hun186/cat-treat-feeder/docs/spoon-sourcing-and-reuse.md

# 常見 PP 圓匙：採購、尺寸與餐後留用

**這不是特殊的專用貓匙。** 類似的 PP 大圓匙可能就是一般餐廳供餐時附上的塑膠湯匙。相同的 155 mm 全長並不保證卡扣相容，必須核對柄寬、厚度與彎曲形狀。

## 已量測的範例匙（一般尺量，非正式公差）
- PP 大圓匙（不是大叉匙或叉匙）；總長約 **155 mm**，勺面寬約 **43 mm**、長約 **50 mm**。
- 柄最窄約 **9 mm**、最寬約 **14 mm**，厚約 **6 mm**，略有弧度。
- 距柄尾端：最寬處 **35 mm**、最窄處 **87 mm**、匙頭交界 **102 mm**。
- V1.14 前後卡扣距離 **52 mm**；前卡扣內寬 9.5 mm／入口 8.7 mm，後卡扣內寬 13.5 mm／入口 11.7 mm。

## 市售購買參考
賣場商品名稱：**大圓匙 大叉匙 100入/包 塑膠湯匙 免洗餐具 塑膠餐具 甜品湯匙 餐廚用品 圓匙 湯匙 走道G**。
請選 **「大圓匙」** 規格：[蝦皮商品頁](https://shopee.tw/%E5%A4%A7%E5%9C%93%E5%8C%99-%E5%A4%A7%E5%8F%89%E5%8C%99-100%E5%85%A5-%E5%8C%85-%E5%A1%91%E8%86%A0%E6%B9%AF%E5%8C%99-%E5%85%8D%E6%B4%97%E9%A4%90%E5%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)。

**包數不一致提醒：** 商品標題寫「100入／包」，先前的到貨包裝照片卻標示「50 PCS／包」；未證實兩者是否同款包裝。以當下賣場選項與實物為準。該連結僅是採購來源範例，非商業背書或食品認證。

## 餐後留用：降低浪費的一個方法
若餐廳提供了相同形狀、尺寸吻合的 PP 圓匙，用餐後可留下來：
1. 確認無裂痕、缺口、尖角或嚴重刮痕，不使用已變形的食匙。
2. 以洗碗精充分洗淨口水、食物與調味料，再用清水沖洗乾淨，晾乾並以潔淨容器收存。
3. 將它作為某隻貓的**個別乾淨食匙**，而不是直接給多隻貓輪流舔食。
4. 在跨地域、多貓或動物送養場域，**優先使用未用過的新匙並遵守場域 SOP**。清洗不等同已消毒，更不等於無菌。

## 風險應如何理解
- **主要避免的是貓與貓之間的間接傳播**。FCV 可經污染的食器等傳播；FPV 亦有環境與器具的間接傳播途徑。
- **人與貓的感染風險不是零**：特定貓病原（例如 FCV）不感染人，但仍有部分人畜共通病原。用餐後留下的湯匙須妥善清洗，不能把「人貓通常不同病」當作免清洗理由。
- 換匙只解決接觸端；若 3D 列印本體、手部或貓條袋沾到唾液，仍須清潔／適當消毒。
- 商用 PP 餐具需查商品的食品接觸標示，不能只看賣場文案認定符合規範。

參考：[Cornell FCV](https://www.vet.cornell.edu/departments-centers-and-institutes/baker-institute-animal-health/research-baker-institute/feline-calicivirus) · [Cornell FPV](https://www.vet.cornell.edu/departments-centers-and-institutes/cornell-feline-health-center/health-information/feline-health-topics/feline-panleukopenia-virus) · [CDC 清潔與消毒寵物用品](https://www.cdc.gov/healthy-pets/about/cleaning-and-disinfecting-pet-supplies.html) · [CDC Cats](https://www.cdc.gov/healthy-pets/about/cats.html)
