hun186/cat-treat-feeder/current/squeeze_slider_v1_14.stl

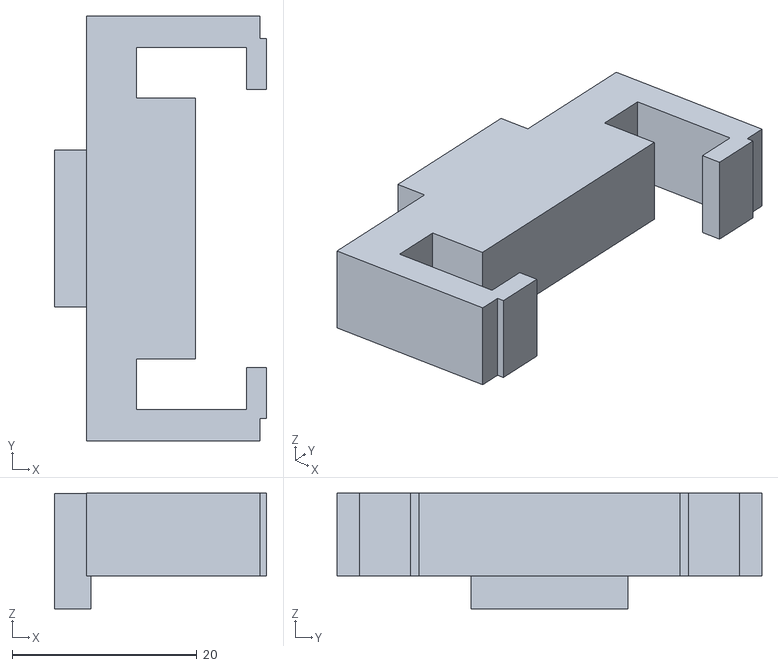
[picture p1: CAD file, 2026-11-04]
current/squeeze_slider_v1_14.stl
23.0 x 46.0 x 12.5
