hun186/cat-treat-feeder/history/v1.13/base_body_v1_13.stl

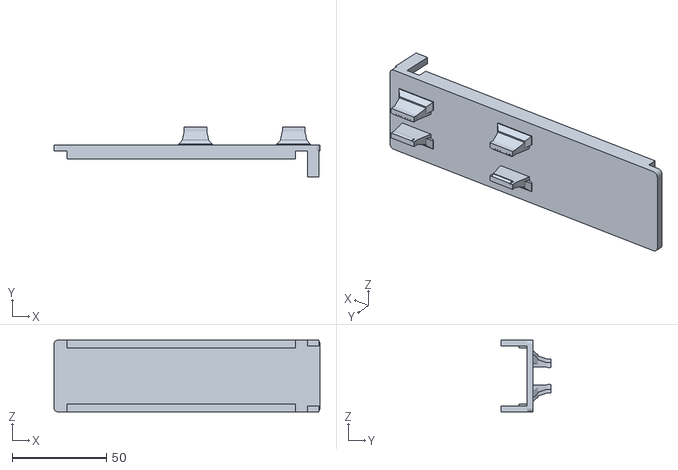
[picture p2: CAD file, 2026-11-04]
history/v1.13/base_body_v1_13.stl
141.0 x 26.5 x 38.0
