hun186/cat-treat-feeder/current/two_point_52mm_front_snap.stl

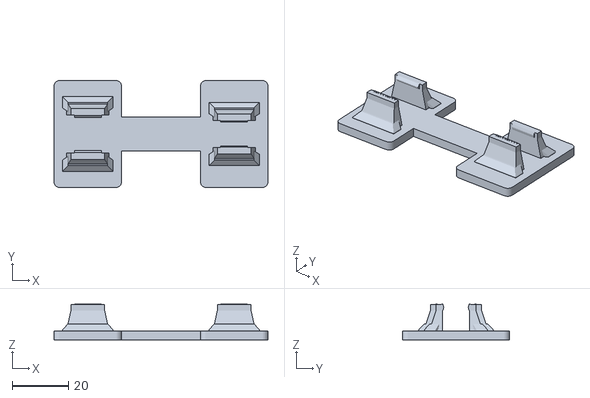
[picture p3: CAD file, 2026-11-04]
current/two_point_52mm_front_snap.stl
76.0 x 38.0 x 12.7
