hun186/cat-treat-feeder/current/front_snap_coupon_9p5_mouth8p7.stl

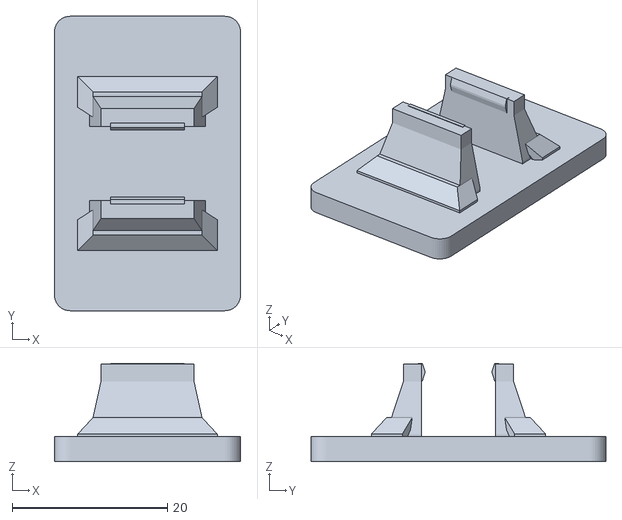
[picture p4: CAD file, 2026-11-04]
current/front_snap_coupon_9p5_mouth8p7.stl
24.0 x 38.0 x 12.7
