hun186/cat-treat-feeder/history/v1.11/base_body_v1_11.stl

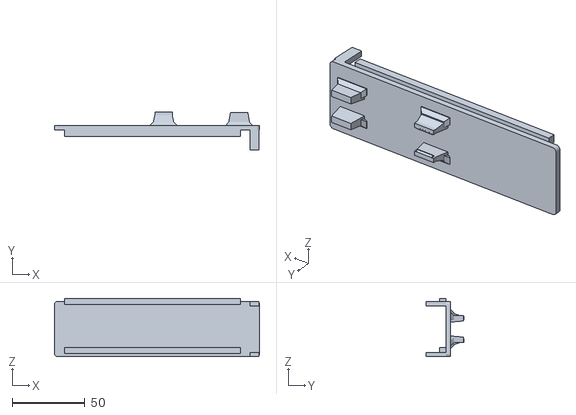
[picture p5: CAD file, 2026-11-04, an earlier design]
history/v1.11/base_body_v1_11.stl
141.0 x 26.5 x 40.1
