hun186/cat-treat-feeder/history/v1.0/base_body.stl

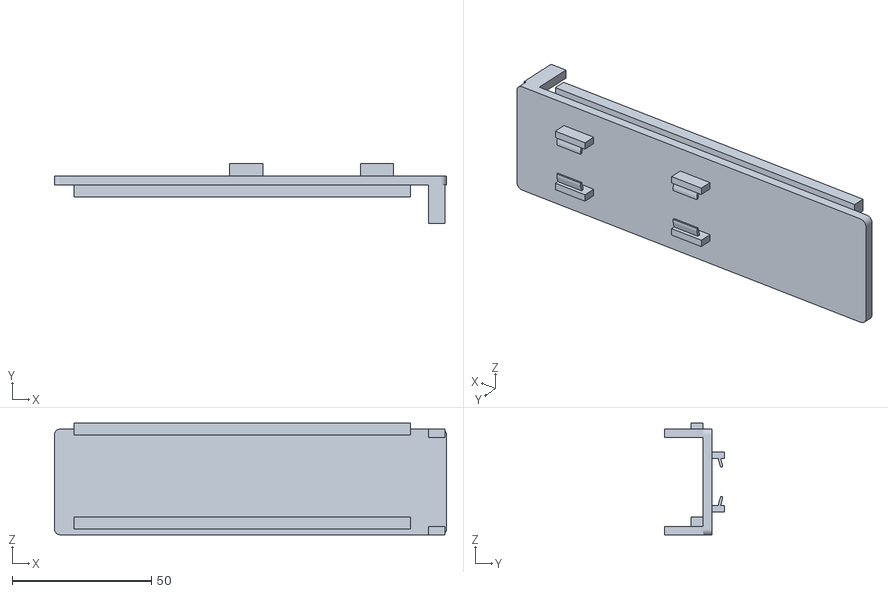
[picture p6: CAD file, 2026-11-04, an earlier design]
history/v1.0/base_body.stl
141.0 x 21.5 x 40.1
