hun186/cat-treat-feeder/(list of files, cad)

Other CAD files:
current/base_body_v1_14_front_flush.stl
history/v1.0/squeeze_slider.stl
history/v1.12/base_body_v1_12.stl
history/v1.0/cat_treat_feeder_v1.scad
history/v1.1/cat_treat_feeder_v1_1.scad
history/v1.11/cat_treat_feeder_v1_11.scad
history/v1.12/cat_treat_feeder_v1_12.scad
