hun186/cat-treat-feeder/docs/next-steps.md

# 下一步 / 測試交接

1. V1.14：用實際到貨的 PP 大圓匙試裝前端 8.7 mm 入口淺倒鉤，確認可固定、又不會斷根。
2. 驗證後端卡扣在連續裝卸時是否仍有退出困難，以及兩卡扣的 52 mm 相對位置。
3. 直立列印重新檢查 V1.14 前擋板是否不再需要那一小段支撐。
4. 滑塊空載測整段行程；檢查不同貓條袋寬，確認肉泥只落在替換湯匙中。
5. 實物驗收失敗時先修卡扣尺寸／底座結構，再升級文件與版本；不要把 STL 的 watertight 當作使用安全證明。
