hun186/cat-treat-feeder/docs/printing-and-fit.md

# 列印與試裝 SOP（V1.14 工程原型）

1. 先列印 `current/front_snap_coupon_9p5_mouth8p7.stl`，測試前端 9.5 mm 卡扣。曾發生側壁整根從根部斷裂，**禁止硬壓**。
2. 再列印 `current/two_point_52mm_front_snap.stl`，測前後卡扣 52 mm 間距以及取下時是否需要旋轉。
3. 再列印 `current/base_body_v1_14_front_flush.stl` 與 `current/squeeze_slider_v1_14.stl`。先空載確認滑塊能沿全行程順暢移動。
4. 切片時採側立方向檢查底板落地、最前端切面與支撐預覽。V1.14 只移除前端一處多餘懸空，不保證全件完全不需支撐。
5. 建議起始設定：PETG、0.2 mm 層高、約四圈外牆、25–35% 填充；實際須依列印機和受力方向修改。
6. 確認匙柄無鬆脫、裂痕、應力白化、滑塊卡滯及破片風險後，才評估實際餵食；兒童操作須成人監督。未經實物完整驗收前，**不應把 CAD 幾何通過當作產品安全驗收**。

## 清潔與更換

每隻貓一支獨立準備的乾淨食匙；跨貓群優先未使用過的新匙，或遵守場域規範。餐後留下的同款 PP 匙可清洗晾乾再使用，但**清洗不等於消毒**。印製零件須避免接觸食物與貓口；受污染時停止跨貓餵食並清潔消毒。

## 尚未完成的驗收

- 卡扣反覆更換壽命、疲勞與不同 PETG 列印方向的強度
- 真實湯匙柄公差與彎曲干涉
- 肉泥出口到匙面中央的落點與溢出率
- 印製件實際有無遭舔舐、幼兒夾手與零件斷裂
