hun186/cat-treat-feeder/docs/measurements.md

# V1.14 湯匙量測與卡扣幾何

> 使用一般尺量測，存在誤差；這不是 CAD 精密尺寸，也未做公差堆疊驗證。

| 從匙柄尾端起算 | 距離 |
|---|---:|
| 最寬（約 14 mm） | 35 mm |
| 最窄（約 9 mm） | 87 mm |
| 勺柄／匙頭交界 | 102 mm |
| 最寬到最窄 | 52 mm |

柄厚約 6 mm，略有弧度。PP 大圓匙總長 155 mm，勺面寬約 43 mm、長約 50 mm。

V1.14 名義前卡扣內寬 **9.5 mm**（入口 8.7 mm，根部補強）、後卡扣內寬 **13.5 mm**（入口 11.7 mm，根部補強）；雙點中心距 **52 mm**。兩側滑塊軌道左右對稱，名義側向間隙各 0.6 mm。前端擋板／底板共同切面 x=141 mm。

座標是為目前樣品推算，不能用相同長度推定其他餐飲湯匙一定適配。請先測試卡扣試片，切勿以過大力量硬壓。
