hun186/cat-treat-feeder/(commit log)

2026-11-04 cad: upload verified V1.14 base STL
    [base_body_v1_14_front_flush.stl]
2026-11-04 fix(cad): preserve STL line boundaries during import
    [base_body_v1_14_front_flush.stl]
2026-11-04 cad: upload original V1.14 source and fit-test model
    [front_snap_coupon_9p5_mouth8p7.stl]
2026-11-04 cad: add original V1.14 52mm two-point fit coupon
    [two_point_52mm_front_snap.stl]
2026-11-04 cad: upload V1.14 slider STL (geometry retained from V1.1)
    [squeeze_slider_v1_14.stl]
2026-11-04 docs: archive prototype history, spoon dimensions, reusable sourcing, and safety SOP
2026-11-04 ci: add reusable STL geometry checks and validation summary
2026-11-04 docs: compare off-the-shelf vs all-printed vs replaceable spoon and clarify archive status
2026-11-04 archive: add original OpenSCAD milestone sources v1.0 v1.1 v1.11 v1.12
    [cat_treat_feeder_v1.scad, cat_treat_feeder_v1_1.scad, cat_treat_feeder_v1_11.scad, cat_treat_feeder_v1_12.scad]
2026-11-04 archive(v1.0): original base prototype STL
    [base_body.stl]
2026-11-04 archive: add original history/v1.0/squeeze_slider.stl milestone
    [squeeze_slider.stl]
2026-11-04 archive: add original history/v1.11/base_body_v1_11.stl milestone
    [base_body_v1_11.stl]
2026-11-04 archive: add original history/v1.12/base_body_v1_12.stl milestone
    [base_body_v1_12.stl]
2026-11-04 archive: add original history/v1.13/base_body_v1_13.stl milestone
    [base_body_v1_13.stl]
